MDenis27/Piano_Cocktail/Raspberry Pi - Python/RobotProject/img_analyse.jpg

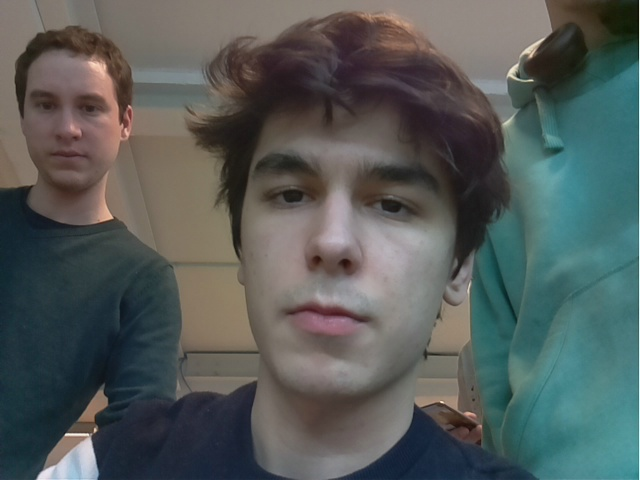
Raspberry Pi - Python/RobotProject/img_analyse.jpg
