MDenis27/Piano_Cocktail/Electronique/Schematique.png

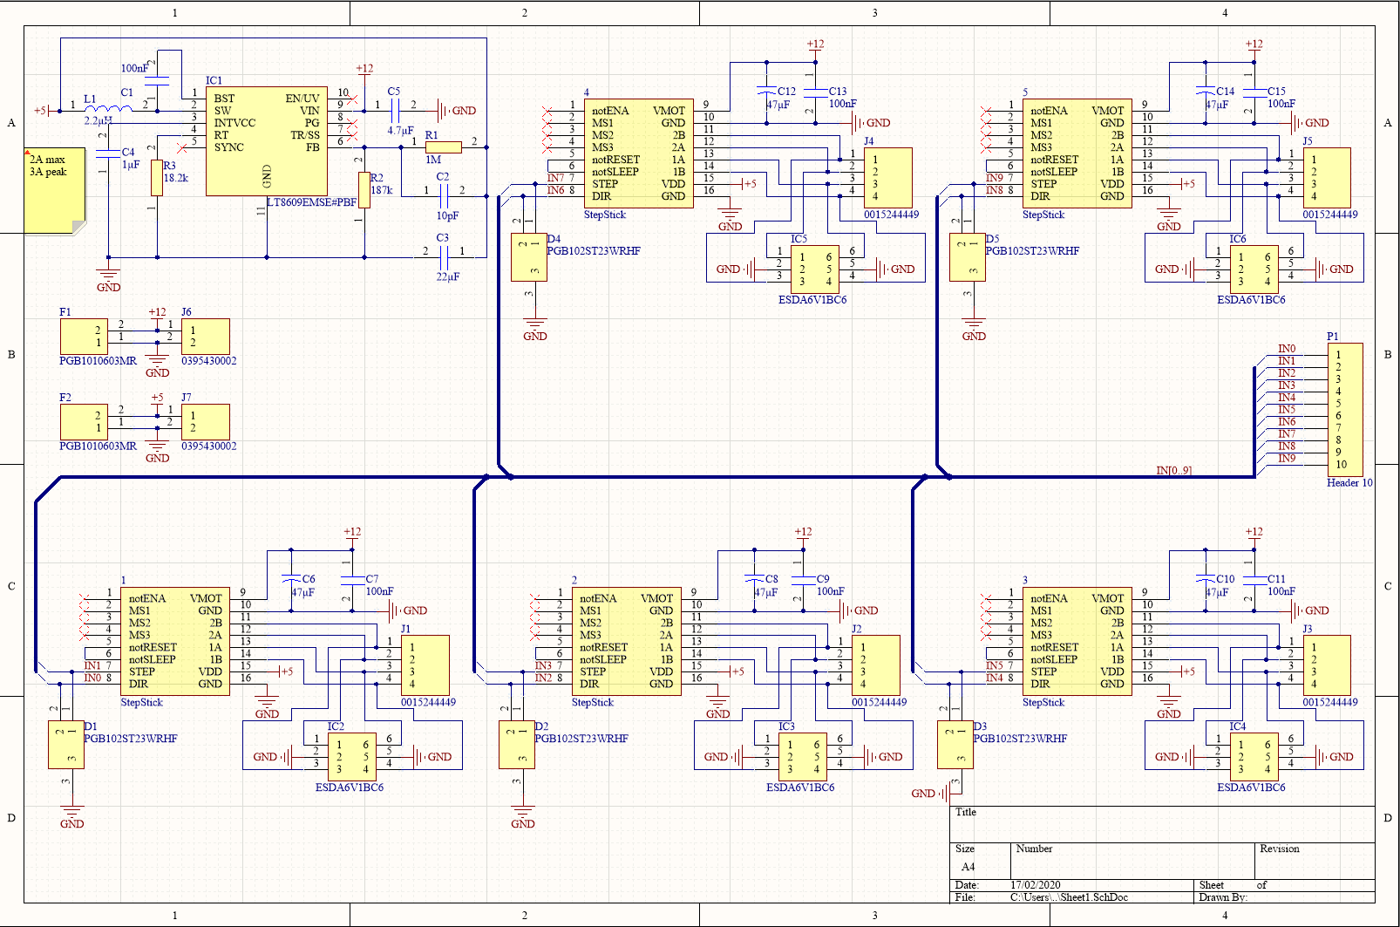
Electronique/Schematique.png
