MDenis27/Piano_Cocktail/Impressions 3D/bouton/LARGE_SWITCH_BUTTON(1).stl

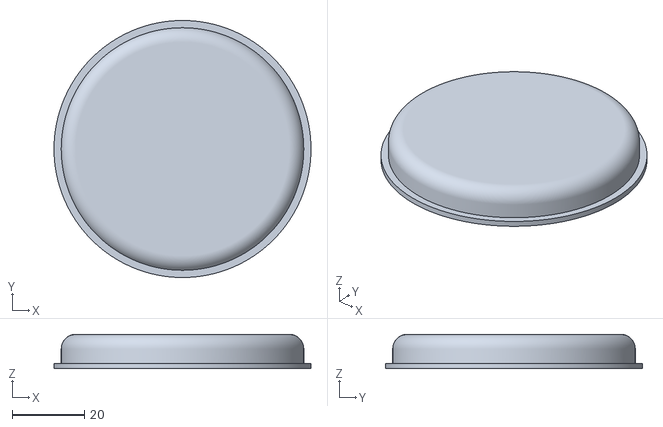
[picture p22: CAD file, 2020-05-14]
Impressions 3D/bouton/LARGE_SWITCH_BUTTON(1).stl
71.0 x 71.0 x 9.50
