MDenis27/Piano_Cocktail/Impressions 3D/picam/picam3.stl

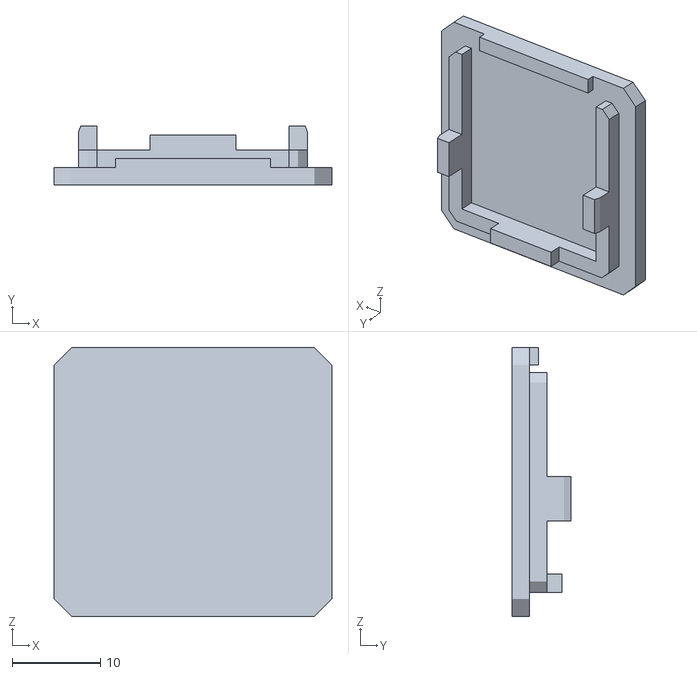
[picture p23: CAD file, 2020-05-14]
Impressions 3D/picam/picam3.stl
31.5 x 6.70 x 30.5
