MDenis27/Piano_Cocktail/Impressions 3D/pompe péristaltique/Body2.stl

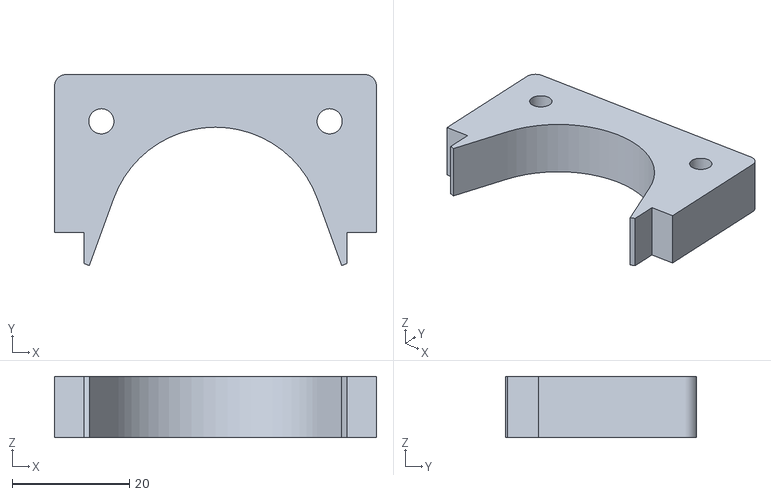
[picture p24: CAD file, 2020-05-14]
Impressions 3D/pompe péristaltique/Body2.stl
55.0 x 32.6 x 10.5
