MDenis27/Piano_Cocktail/Impressions 3D/Speaker125mm.stl

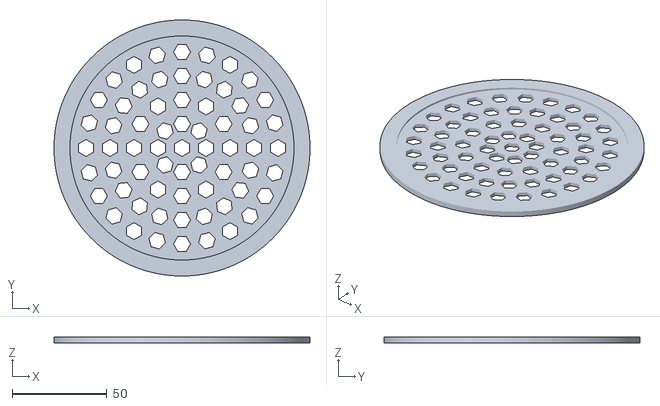
[picture p25: CAD file, 2020-05-14]
Impressions 3D/Speaker125mm.stl
135.0 x 135.0 x 3.00
