MDenis27/Piano_Cocktail/Impressions 3D/support bouteille/SUPPBOTTLE2.stl

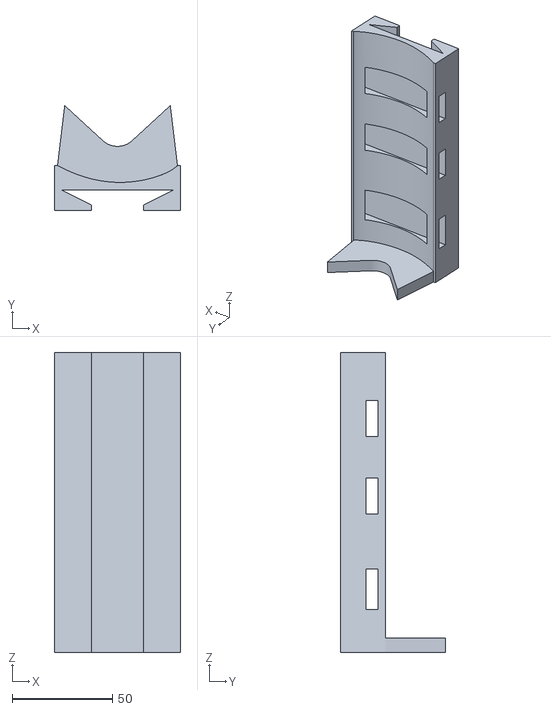
[picture p26: CAD file, 2020-05-14]
Impressions 3D/support bouteille/SUPPBOTTLE2.stl
63.0 x 52.4 x 150.0
