MDenis27/Piano_Cocktail/Impressions 3D/picam/picam2.stl

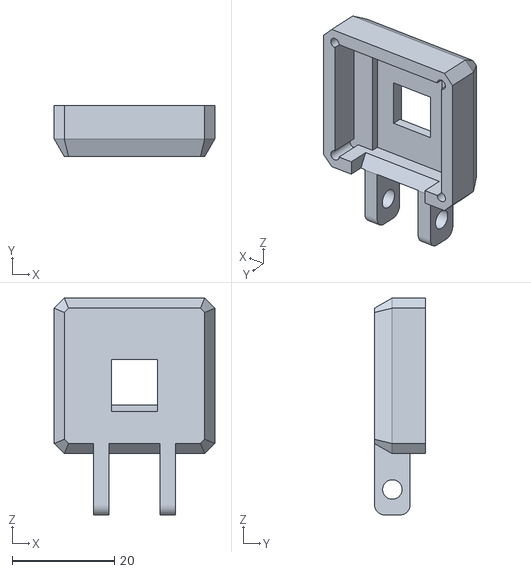
[picture p27: CAD file, 2020-05-14]
Impressions 3D/picam/picam2.stl
31.5 x 10.00 x 42.5
