MDenis27/Piano_Cocktail/Impressions 3D/pompe péristaltique/Body1.stl

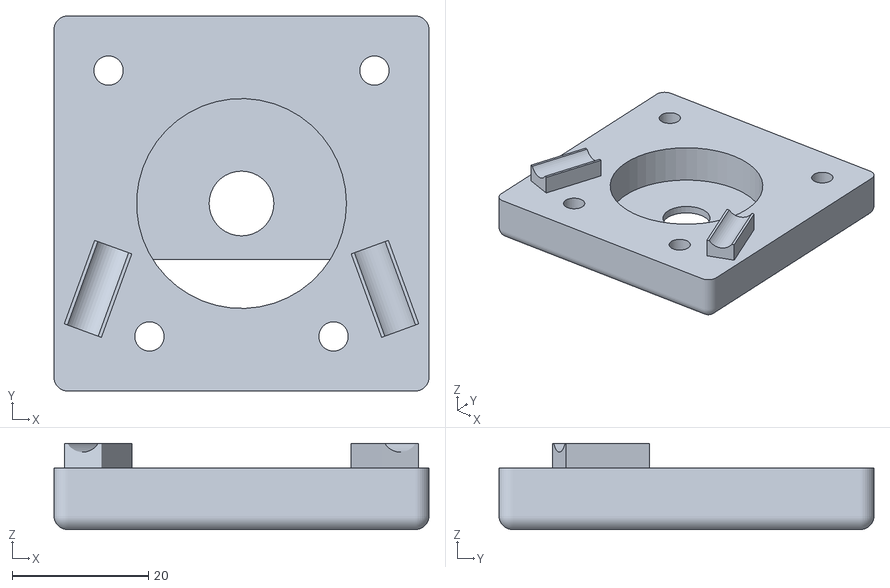
[picture p28: CAD file, 2020-05-14]
Impressions 3D/pompe péristaltique/Body1.stl
55.0 x 55.0 x 12.6
