MDenis27/Piano_Cocktail/Impressions 3D/robinet.stl

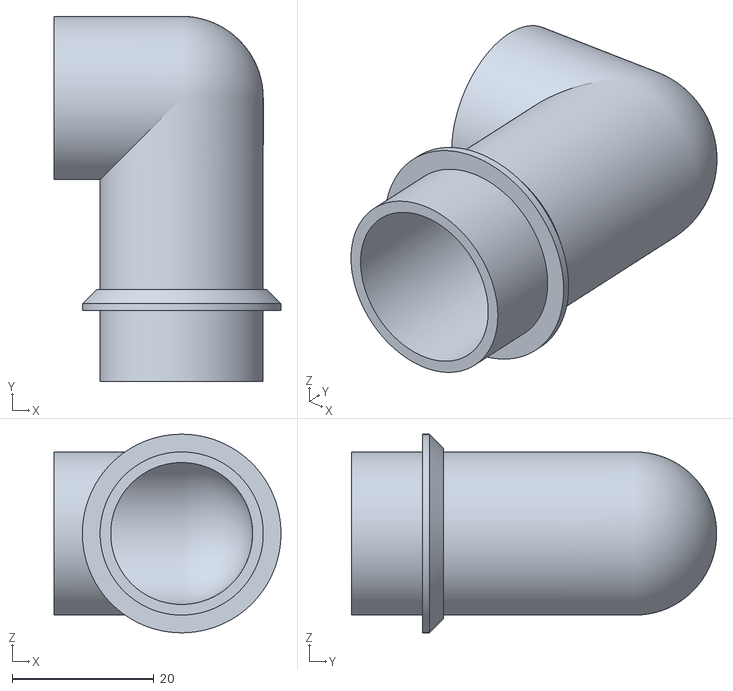
[picture p29: CAD file, 2020-05-14]
Impressions 3D/robinet.stl
32.0 x 51.5 x 28.0
