MDenis27/Piano_Cocktail/Impressions 3D/support bouteille/SUPPBOTTLE.stl

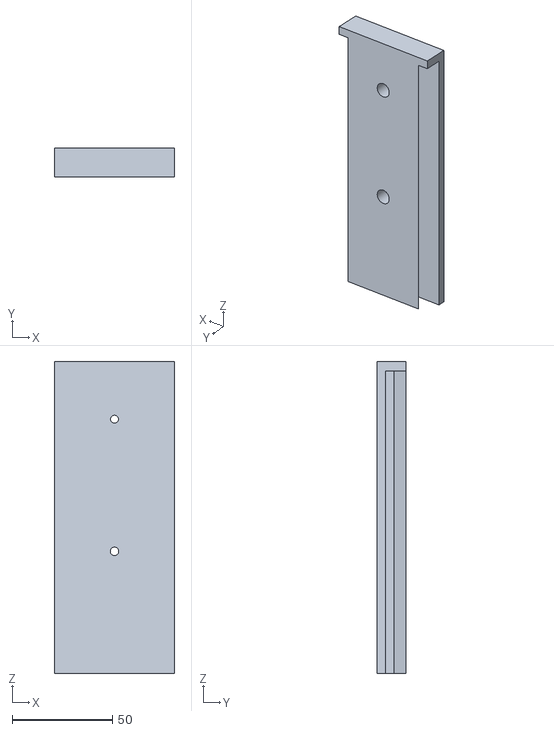
[picture p30: CAD file, 2020-05-14]
Impressions 3D/support bouteille/SUPPBOTTLE.stl
60.0 x 14.4 x 155.8
