MDenis27/Piano_Cocktail/Impressions 3D/picam/Picam1_-_Copie.stl

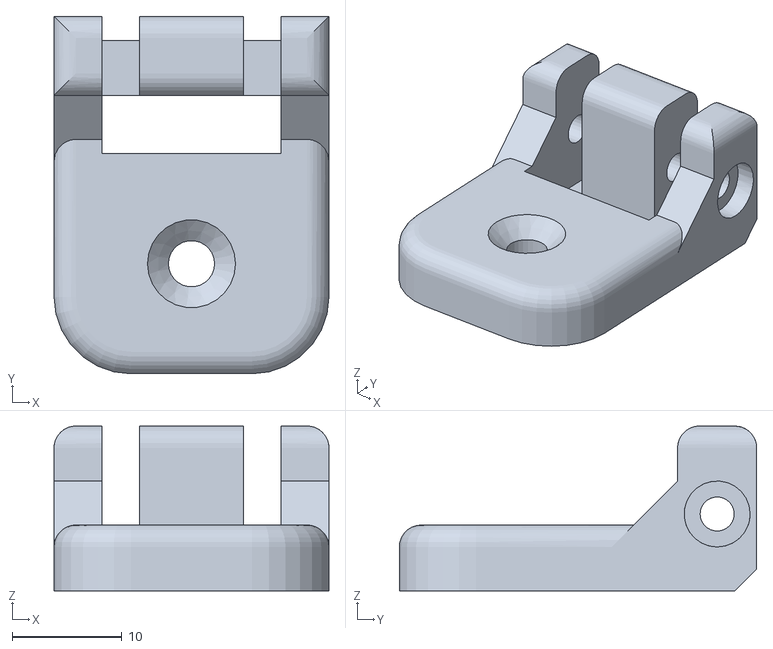
[picture p31: CAD file, 2020-05-14]
Impressions 3D/picam/Picam1_-_Copie.stl
25.0 x 32.5 x 15.0
