MDenis27/Piano_Cocktail/Impressions 3D/pompe péristaltique/Body5.stl

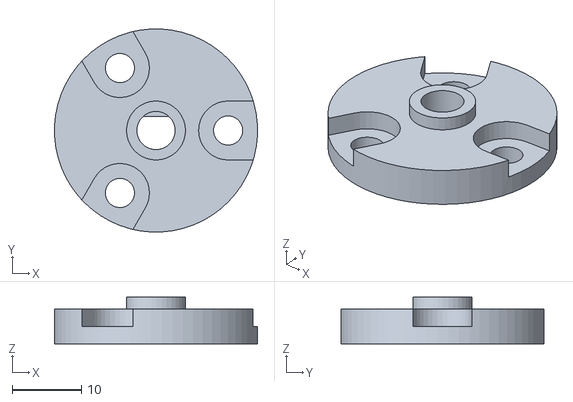
[picture p32: CAD file, 2020-05-14]
Impressions 3D/pompe péristaltique/Body5.stl
29.3 x 29.3 x 6.75
