MDenis27/Piano_Cocktail/Impressions 3D/pompe péristaltique/Body3.stl

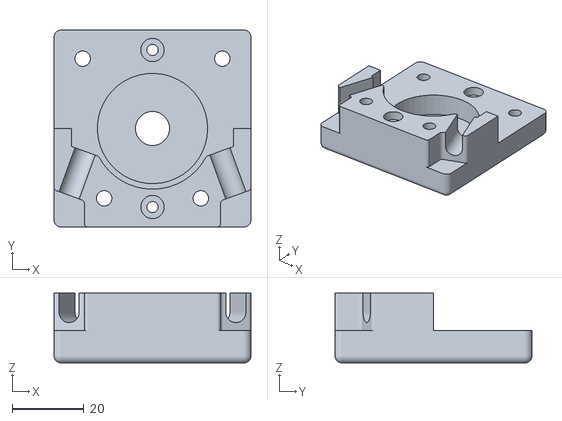
[picture p33: CAD file, 2020-05-14]
Impressions 3D/pompe péristaltique/Body3.stl
55.0 x 55.0 x 19.5
