MDenis27/Piano_Cocktail/(list of files, cad)

Other CAD files:
Impressions 3D/pompe péristaltique/Body4.stl
