MDenis27/Piano_Cocktail/(list of files, drawings)

Other design files:
Electronique/Sheet1.schdoc
