MDenis27/Piano_Cocktail/(commit log)

2020-05-13 Create Arduino Folder & Move Files
2020-05-13 Add Excell Sheet computation
    [PumpFunction.xlsx, PumpFunctionClear.xlsx]
2020-05-13 change name
    [PumpFunction.xlsx, PumpFunctionClear.xlsx]
2020-05-13 update graph range
    [PumpFunction.xlsx]
2020-05-13 improve Pump code
    [PumpFunction.xlsx]
2020-05-13 minor changes (names)
    [PumpFunction.xlsx]
2020-05-13 remove unsued arduino files
2020-05-14 adding python codes from raspberry pi
    + contains the whole project
2020-05-14 adding electronics files
    + bom
    + gerber
    [PCB1_Copper_Signal_Bot.gbr, PCB1_Copper_Signal_Top.gbr, PCB1_Drawing_1.gbr, PCB1_Drillmap_1.gbr, PCB1_Keep-out.gbr, PCB1_Legend_Bot.gbr, PCB1_Legend_Top.gbr, PCB1_Mechanical_1.gbr]
2020-05-14 ajout impressions 3d
    [Body1.stl, Body2.stl, Body3.stl, Body4.stl, Body5.stl, LARGE_SWITCH_BUTTON(1).stl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]
2020-05-14 adding schematic and image
    [Sheet1.schdoc]
2020-05-15 Change led Pin
2020-05-15 debug led strip
2020-05-17 Add Debug Led & test for 0 led
2020-05-17 Add Led for debug
2020-05-17 fix led
2020-05-17 set debug led
2020-05-17 debug led
2020-05-17 led debug
2020-05-17 Change motor config
